padhialuo0426/mic-array-doa/(commit log)

2026-09-23 Initial public release: chirp DOA on AX7020 with TF-card boot
    Seven-microphone I2S capture, AXI DMA, SK9822 ring and 720p60 HDMI in PL;
    CPU0 runs matched-filter first-arrival SRP-PHAT on a periodic 500-6000 Hz
    chirp, CPU1 draws the direction radar and spectrum. scripts/build.ps1 builds
    the bitstream, both A9 programs and BOOT.BIN with Vivado/Vitis 2025.2; the
    board self-tests and starts streaming from a TF card.
    Includes the Linux JTAG loader, which refuses an image that can wake CPU1 but
    lacks the autostart flag it must clear, a chirp test-tone generator, and a
    README covering wiring, building and flashing.
    [ax7020.cfg]
2026-09-24 Build the A9 programs, FSBL and BOOT.BIN without Vitis
    sw/Makefile builds CPU0, CPU1 and the embeddedsw 2025.2 zynq_fsbl with a
    host arm-none-eabi-gcc. sw/bsp vendors the unmodified embeddedsw sources
    (145cea8, MIT; FatFs and md5.c keep their own notices) and the files Vitis
    would generate from top.xsa, each value taken from the Vitis build. The CPU1
    translation table gets the same outer-noncacheable patch as sw/build.py, and
    check_elfs.py repeats its entry, DDR-range, MMU and InitSD checks.
    scripts/build_bootgen.sh builds Xilinx's open-source bootgen 2025.2.
    sw/qemu/boot_check.sh boots BOOT.BIN from an emulated SD card up to the PL
    check, so the boot path can be tested without a board.
    Co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
2026-09-24 Build the bitstream with openXC7; document the open-source flow
    hw/oss replaces the Vivado IP with Verilog (AXI3-to-Lite bridge, the S2MM
    subset of AXI DMA the firmware uses, stream FIFO, DVI rgb2dvi, PS7 top with
    the video MMCM) and build.sh runs yosys, nextpnr-xilinx and prjxray in the
    openXC7 container. It works around three faults seen on the board: data in
    block-RAM parity bits read back as 0, nextpnr leaves the MMCM without
    feedback, and canvas writes failed at 100 MHz despite a passing report.
    The shared canvas and LED RTL gains the pipeline stages this needed; Vivado
    still meets timing with the same BRAM count. Built this way, BOOT.BIN
    cold-boots from the TF card with correct HDMI,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
    [axi3_lite_bridge.v, axis_fifo.v, canvas_ram.v, oss.xdc, oss_fabric.v, rgb2dvi.v, s2mm_dma.v, sk9822_driver.v]
2026-09-24 Build with the open-source flow on macOS
    hw/oss/build.sh runs the x86-64 openXC7 image with Apple's container
    tool under Rosetta on macOS, with 8 GB of memory; Linux still uses
    Docker. scripts/build_bootgen.sh uses getconf instead of nproc and, on
    macOS, builds bootgen through its Linux branch with Homebrew's OpenSSL
    and a <malloc.h> stand-in.
    docs/open-toolchain.md sets out the Linux and macOS prerequisites side
    by side, with the Arm GNU Toolchain cask on macOS, and notes build times
    for both. A BOOT.BIN built on macOS boots from the TF card and passes the
    chirp DOA test on the board.
